tk20dk/odie/kicad/odie.pcb.png

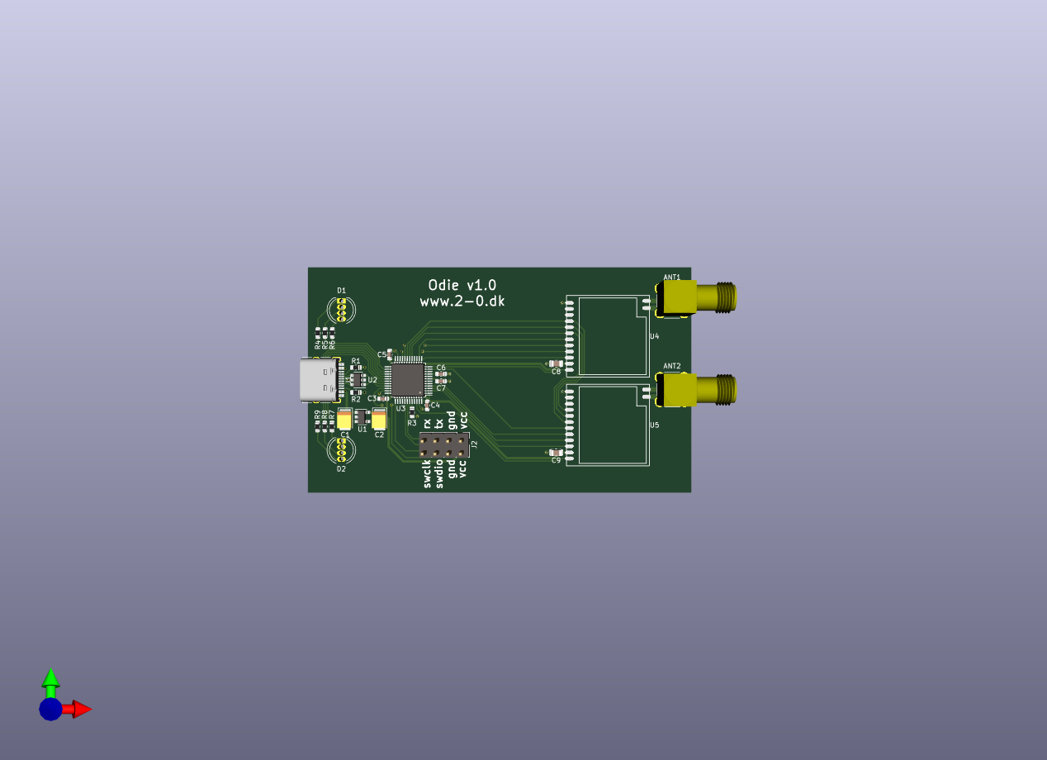
kicad/odie.pcb.png
