tk20dk/odie/kicad/odie.kicad_pcb

## KiCad design kicad/odie.kicad_pcb (2020-11-19)

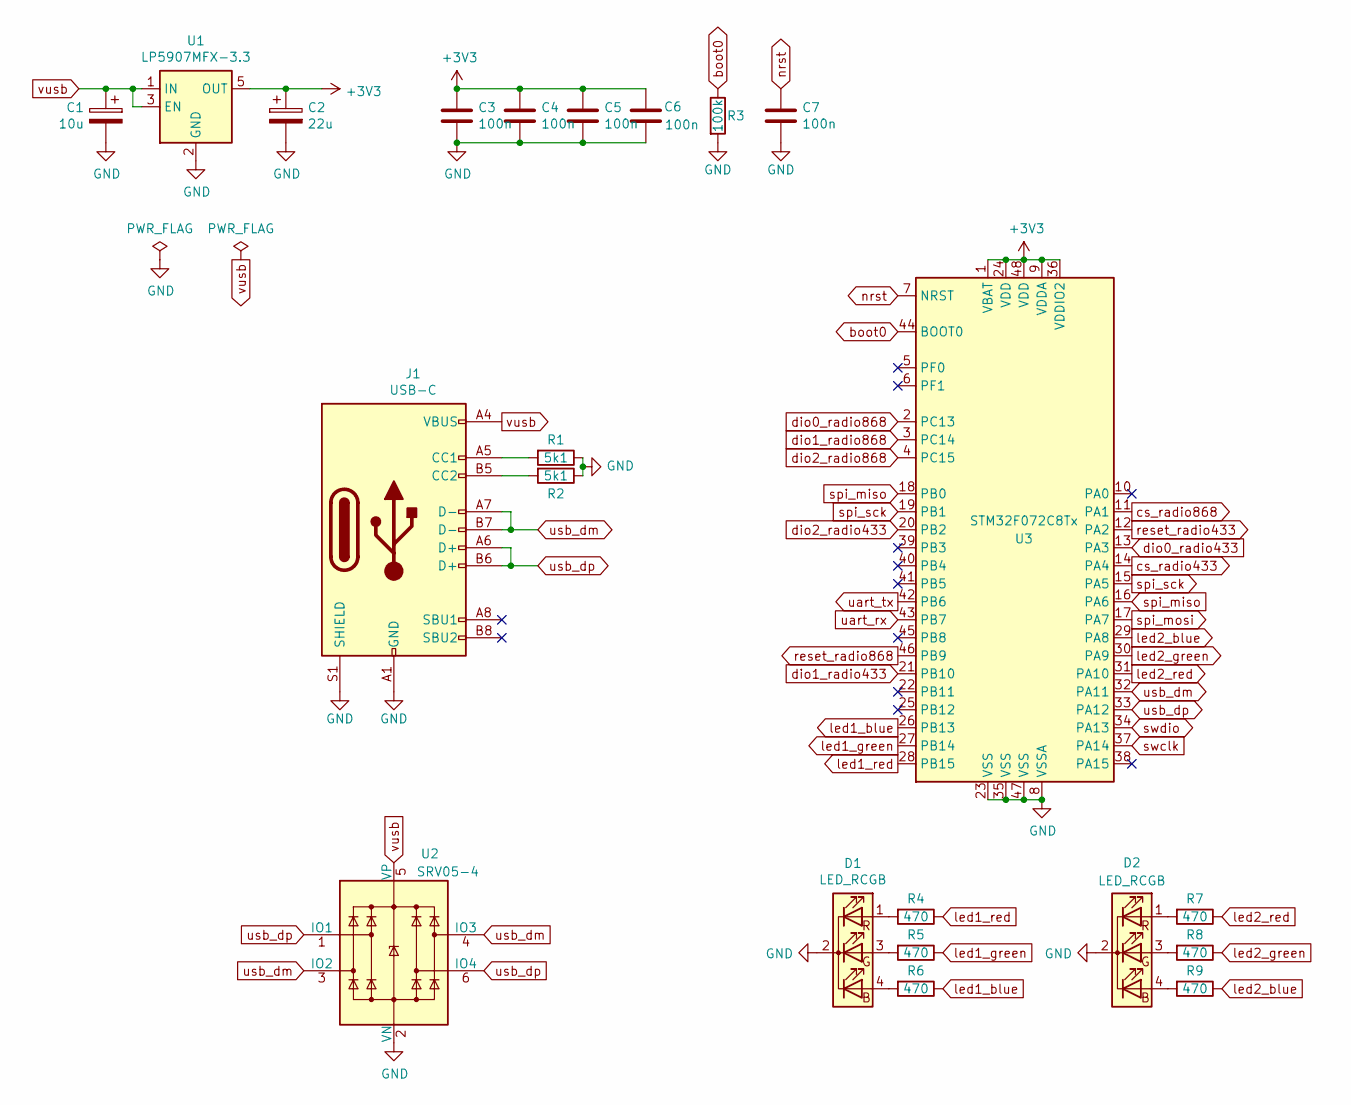
[picture p5: schematic processor.sch, Odie]

Parts:
C1: 10u; CP_EIA-3528-12_Kemet-T
C2: 22u; CP_EIA-3528-12_Kemet-T
C3, C4, C5, C6, C7: 100n; C_0603_1608Metric
D1, D2: LED_RCGB; LED_D5.0mm-4
J1: USB-C; USB_C_Receptacle_HRO_TYPE-C-31-M-12
R1, R2: 5k1; R_0603_1608Metric
R3: 100k; R_0603_1608Metric
R4, R5, R6, R7, R8, R9: 470; R_0603_1608Metric
U1: LP5907MFX-3.3; SOT-23-5
U2: SRV05-4; SOT-23-6
U3: STM32F072C8Tx; LQFP-48_7x7mm_P0.5mm

Connections:
GND: C1.2, C2.2, C3.2, C4.2, C5.2, C6.2, C7.2, D1.2 (K), D2.2 (K), J1.A1 (GND), J1.A12 (GND), J1.B1 (GND), J1.B12 (GND), J1.S1 (SHIELD), R1.1, R2.1, R3.2, U1.2 (GND), U2.2 (VN), U3.8 (VSSA), U3.23 (VSS), U3.35 (VSS), U3.47 (VSS); also elsewhere on the board
unnamed: D1.1 (RA), R4.2
unnamed: D1.3 (GA), R5.2
unnamed: D1.4 (BA), R6.2
unnamed: D2.1 (RA), R7.2
unnamed: D2.3 (GA), R8.2
unnamed: D2.4 (BA), R9.2
unnamed: J1.A5 (CC1), R1.2
unnamed: J1.B5 (CC2), R2.2
boot0: R3.1, U3.44 (BOOT0)
cs_radio433: U3.14 (PA4); also elsewhere on the board
cs_radio868: U3.11 (PA1); also elsewhere on the board
dio0_radio433: U3.13 (PA3); also elsewhere on the board
dio0_radio868: U3.2 (PC13); also elsewhere on the board
dio1_radio433: U3.21 (PB10); also elsewhere on the board
dio1_radio868: U3.3 (PC14); also elsewhere on the board
dio2_radio433: U3.20 (PB2); also elsewhere on the board
dio2_radio868: U3.4 (PC15); also elsewhere on the board
led1_blue: R6.1, U3.26 (PB13)
led1_green: R5.1, U3.27 (PB14)
led1_red: R4.1, U3.28 (PB15)
led2_blue: R9.1, U3.29 (PA8)
led2_green: R8.1, U3.30 (PA9)
led2_red: R7.1, U3.31 (PA10)
nrst: C7.1, U3.7 (NRST)
reset_radio433: U3.12 (PA2); also elsewhere on the board
reset_radio868: U3.46 (PB9); also elsewhere on the board
spi_miso: U3.16 (PA6), U3.18 (PB0); also elsewhere on the board
spi_mosi: U3.17 (PA7); also elsewhere on the board
spi_sck: U3.15 (PA5), U3.19 (PB1); also elsewhere on the board
swclk: U3.37 (PA14); also elsewhere on the board
swdio: U3.34 (PA13); also elsewhere on the board
uart_rx: U3.43 (PB7); also elsewhere on the board
uart_tx: U3.42 (PB6); also elsewhere on the board
usb_dm: J1.A7 (D-), J1.B7 (D-), U2.3 (IO2), U2.4 (IO3), U3.32 (PA11)
usb_dp: J1.A6 (D+), J1.B6 (D+), U2.1 (IO1), U2.6 (IO4), U3.33 (PA12)
vusb: C1.1, J1.A4 (VBUS), J1.A9 (VBUS), J1.B4 (VBUS), J1.B9 (VBUS), U1.1 (IN), U1.3 (EN), U2.5 (VP)

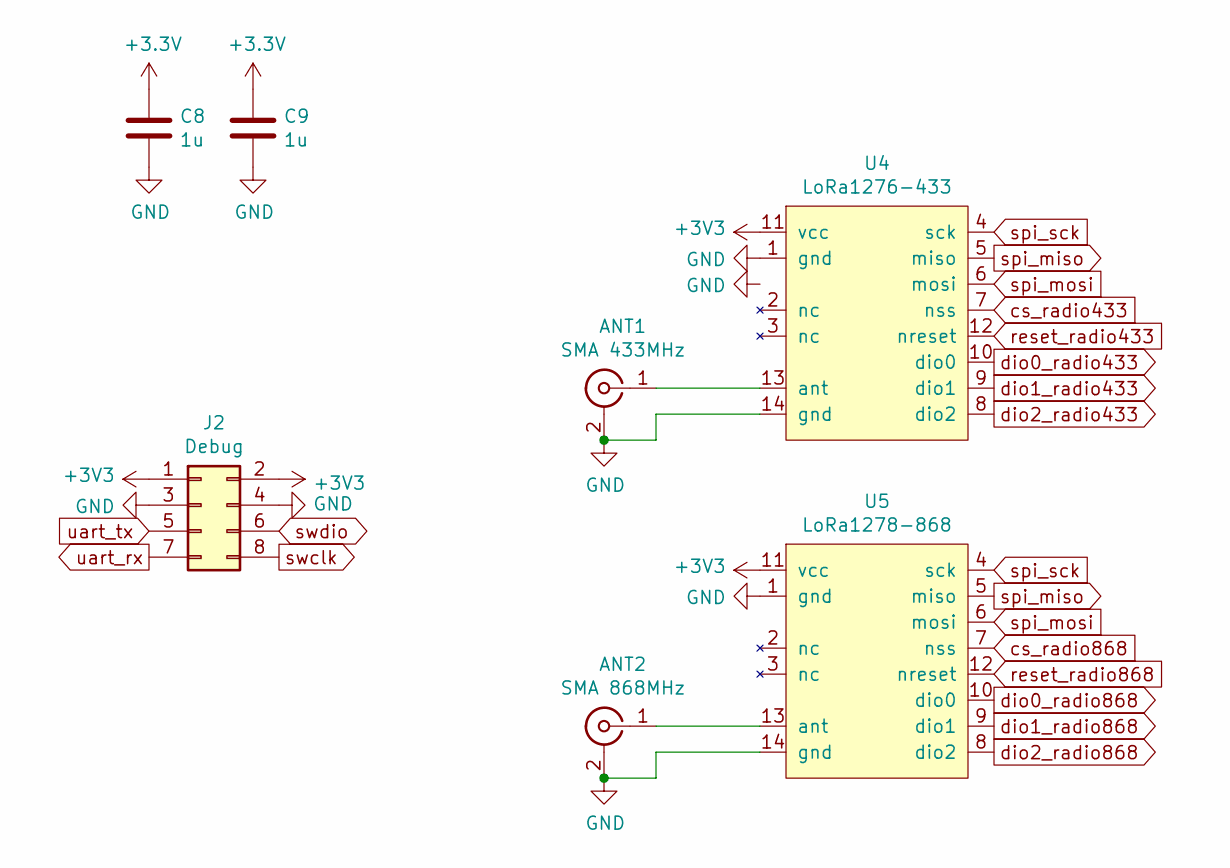
[picture p6: schematic radio.sch, Odie]

Parts:
ANT1: SMA 433MHz; SMA_Molex_73251-2200_Horizontal
ANT2: SMA 868MHz; SMA_Molex_73251-2200_Horizontal
C8, C9: 1u; C_0805_2012Metric
J2: Debug; PinHeader_2x04_P2.54mm_Vertical
U4: LoRa1276-433; NicerRF-LoRa1276
U5: LoRa1278-868; NicerRF-LoRa1276

Connections:
GND: ANT1.2 (Ext), ANT2.2 (Ext), C8.2, C9.2, J2.3, J2.4, U4.1 (gnd), U4.14 (gnd), U5.1 (gnd), U5.14 (gnd); also elsewhere on the board
unnamed: ANT1.1 (In), U4.13 (ant)
unnamed: ANT2.1 (In), U5.13 (ant)
cs_radio433: U4.7 (nss); also elsewhere on the board
cs_radio868: U5.7 (nss); also elsewhere on the board
dio0_radio433: U4.10 (dio0); also elsewhere on the board
dio0_radio868: U5.10 (dio0); also elsewhere on the board
dio1_radio433: U4.9 (dio1); also elsewhere on the board
dio1_radio868: U5.9 (dio1); also elsewhere on the board
dio2_radio433: U4.8 (dio2); also elsewhere on the board
dio2_radio868: U5.8 (dio2); also elsewhere on the board
reset_radio433: U4.12 (nreset); also elsewhere on the board
reset_radio868: U5.12 (nreset); also elsewhere on the board
spi_miso: U4.5 (miso), U5.5 (miso); also elsewhere on the board
spi_mosi: U4.6 (mosi), U5.6 (mosi); also elsewhere on the board
spi_sck: U4.4 (sck), U5.4 (sck); also elsewhere on the board
swclk: J2.8; also elsewhere on the board
swdio: J2.6; also elsewhere on the board
uart_rx: J2.7; also elsewhere on the board
uart_tx: J2.5; also elsewhere on the board

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
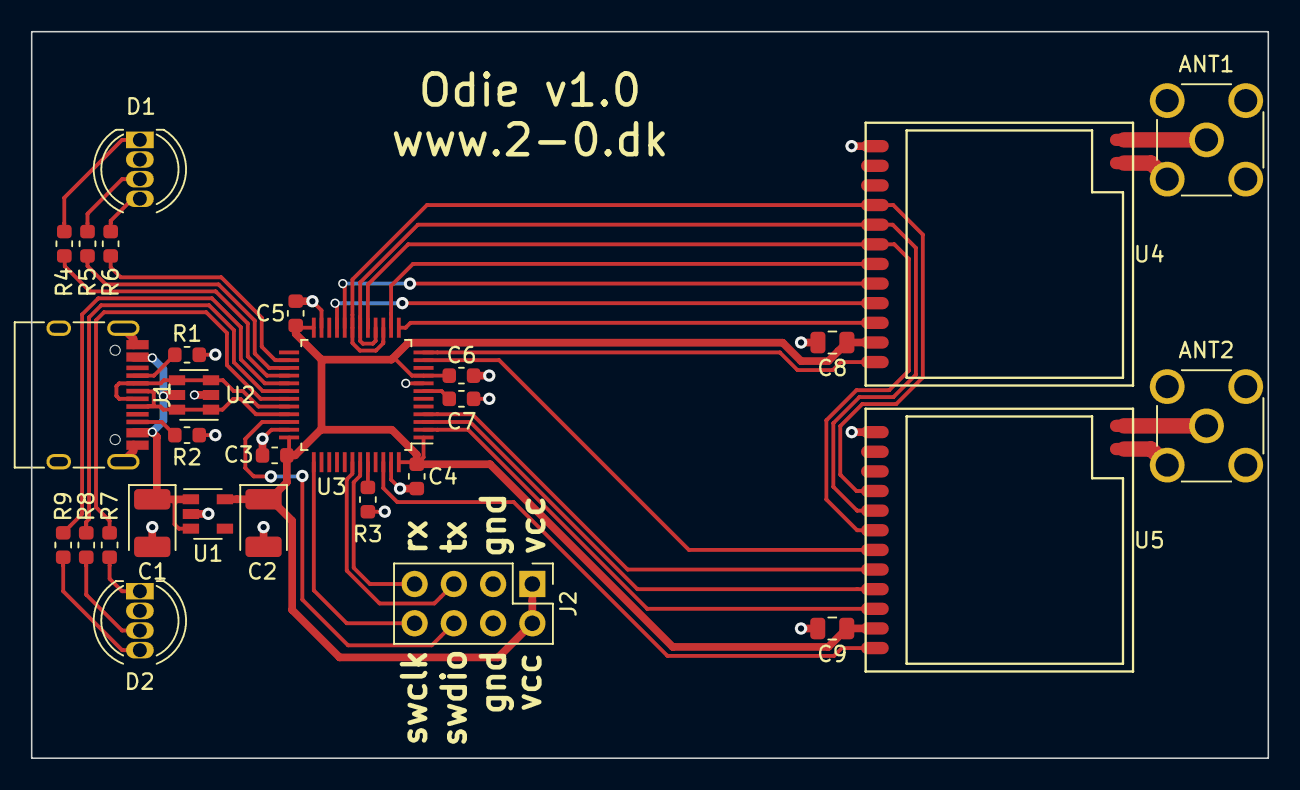
[picture p7: board odie.kicad_pcb from above]

Board: 2 copper layers, 80.0 x 47.0 mm, 29 parts (0 on the bottom side), 40 nets.
