tk20dk/odie/stm32/Core/Inc/main.h

#define DIO0_RADIO868_Pin GPIO_PIN_13
#define DIO0_RADIO868_GPIO_Port GPIOC
#define DIO0_RADIO868_EXTI_IRQn EXTI4_15_IRQn
#define DIO1_RADIO868_Pin GPIO_PIN_14
#define DIO1_RADIO868_GPIO_Port GPIOC
#define DIO1_RADIO868_EXTI_IRQn EXTI4_15_IRQn
#define DIO2_RADIO868_Pin GPIO_PIN_15
#define DIO2_RADIO868_GPIO_Port GPIOC
#define DIO2_RADIO868_EXTI_IRQn EXTI4_15_IRQn
#define CS_RADIO868_Pin GPIO_PIN_1
#define CS_RADIO868_GPIO_Port GPIOA
#define RESET_RADIO433_Pin GPIO_PIN_2
#define RESET_RADIO433_GPIO_Port GPIOA
#define DIO0_RADIO433_Pin GPIO_PIN_3
#define DIO0_RADIO433_GPIO_Port GPIOA
#define DIO0_RADIO433_EXTI_IRQn EXTI2_3_IRQn
#define CS_RADIO433_Pin GPIO_PIN_4
#define CS_RADIO433_GPIO_Port GPIOA
#define SPI_MISO_Pin GPIO_PIN_0
#define SPI_MISO_GPIO_Port GPIOB
#define SPI_SCK_Pin GPIO_PIN_1
#define SPI_SCK_GPIO_Port GPIOB
#define DIO2_RADIO433_Pin GPIO_PIN_2
#define DIO2_RADIO433_GPIO_Port GPIOB
#define DIO2_RADIO433_EXTI_IRQn EXTI2_3_IRQn
#define DIO1_RADIO433_Pin GPIO_PIN_10
#define DIO1_RADIO433_GPIO_Port GPIOB
#define DIO1_RADIO433_EXTI_IRQn EXTI4_15_IRQn
#define LED1_BLUE_Pin GPIO_PIN_13
#define LED1_BLUE_GPIO_Port GPIOB
#define LED1_GREEN_Pin GPIO_PIN_14
#define LED1_GREEN_GPIO_Port GPIOB
#define LED1_RED_Pin GPIO_PIN_15
#define LED1_RED_GPIO_Port GPIOB
#define LED2_BLUE_Pin GPIO_PIN_8
#define LED2_BLUE_GPIO_Port GPIOA
#define LED2_GREEN_Pin GPIO_PIN_9
#define LED2_GREEN_GPIO_Port GPIOA
#define LED2_RED_Pin GPIO_PIN_10
#define LED2_RED_GPIO_Port GPIOA
#define RESET_RADIO868_Pin GPIO_PIN_9
#define RESET_RADIO868_GPIO_Port GPIOB
