tk20dk/odie/stm32/Core/Inc/odie.h

#ifndef ODIE_H_
#define ODIE_H_

#include "gps.h"
#include "main.h"
#include "sx1276.h"


class TOdie
{
public:
  TOdie();

  void Loop();
  void Setup();
  void HAL_GPIO_EXTI_Callback( uint16_t const GPIO_Pin );

private:
  void HmiError();
  void Hmi1Error();
  void Hmi2Error();
  void Hmi1Blue( uint32_t const Interval = 0 );
  void Hmi2Blue( uint32_t const Interval = 0 );
  void HmiLoop();
  void Radio433Event( TRadioEvent const Event );
  void Radio868Event( TRadioEvent const Event );

private:
  bool Radio433Flag;
  bool Radio868Flag;
  TSx1276 Radio433;
  TSx1276 Radio868;
  uint32_t TimeoutHmiBlue1;
  uint32_t TimeoutHmiBlue2;
};

#endif // ODIE_H_
